Ashtonantony28/nanoxl-accelerator/bench/results/roofline.csv

table | fix | board | model | wbits | N | lanes | mhz | ddr_gbps | kv | batch | fits | prefill_T | prefill_chunk | prefill_ms | prefill_array_util | prefill_gops | decode_tok_s | weight_bound_tok_s | decode_step_us | decode_ddr_util | decode_ddr_MB_per_step | decode_ops_per_byte | decode_gops | why
boards |  | kv260 | tiny | 8 | 32 | 64 | 250.0 | 8.0 | onchip | 1 | True | 128 | 128 | 0.9686 | 0.4779 | 244.6893 | 5317.0749 | 10066.0332 | 188.0733 | 0.585 | 0.8798 | 1.9572 | 9.1557
boards |  | kv260 | tiny | 8 | 32 | 64 | 250.0 | 8.0 | onchip | 4 | True |  |  |  |  |  | 15911.5741 | 40264.1327 | 251.3893 | 0.4415 | 0.881 | 7.8185 | 27.3988
boards |  | kv260 | tiny | 8 | 32 | 64 | 250.0 | 8.0 | onchip | 8 | True |  |  |  |  |  | 23729.9531 | 80528.2654 | 337.1267 | 0.3334 | 0.8825 | 15.6097 | 40.8616
boards |  | kv260 | tiny | 8 | 32 | 64 | 250.0 | 8.0 | ddr | 1 | True | 128 | 128 | 1.2665 | 0.3655 | 187.1444 | 5091.5806 | 10066.0332 | 196.4027 | 0.6023 | 0.947 | 1.8182 | 8.7674
boards |  | kv260 | tiny | 8 | 32 | 64 | 250.0 | 8.0 | ddr | 4 | True |  |  |  |  |  | 14379.8682 | 40264.1327 | 278.1667 | 0.5124 | 1.1499 | 5.9898 | 24.7613
boards |  | kv260 | tiny | 8 | 32 | 64 | 250.0 | 8.0 | ddr | 8 | True |  |  |  |  |  | 20649.5665 | 80528.2654 | 387.4173 | 0.4485 | 1.4204 | 9.6981 | 35.5573
boards |  | kv260 | tiny | 4 | 32 | 64 | 250.0 | 8.0 | onchip | 1 | True | 128 | 128 | 0.9992 | 0.4633 | 237.2093 | 5818.1028 | 19923.4938 | 171.8773 | 0.363 | 0.4989 | 3.4517 | 10.0184
boards |  | kv260 | tiny | 4 | 32 | 64 | 250.0 | 8.0 | onchip | 4 | True |  |  |  |  |  | 16628.8822 | 79693.9751 | 240.5453 | 0.262 | 0.5 | 13.7749 | 28.634
boards |  | kv260 | tiny | 4 | 32 | 64 | 250.0 | 8.0 | onchip | 8 | True |  |  |  |  |  | 23914.6724 | 159387.9503 | 334.5227 | 0.191 | 0.5016 | 27.4649 | 41.1797
boards |  | kv260 | tiny | 4 | 32 | 64 | 250.0 | 8.0 | ddr | 1 | True | 128 | 128 | 1.3071 | 0.3541 | 181.3214 | 5391.1843 | 19923.4938 | 185.488 | 0.3808 | 0.5661 | 3.0417 | 9.2833
boards |  | kv260 | tiny | 4 | 32 | 64 | 250.0 | 8.0 | ddr | 4 | True |  |  |  |  |  | 14745.1304 | 79693.9751 | 271.276 | 0.3488 | 0.769 | 8.9568 | 25.3902
boards |  | kv260 | tiny | 4 | 32 | 64 | 250.0 | 8.0 | ddr | 8 | True |  |  |  |  |  | 20740.7203 | 159387.9503 | 385.7147 | 0.3255 | 1.0395 | 13.252 | 35.7143
boards |  | kv260 | shakespeare | 8 | 32 | 64 | 250.0 | 8.0 | onchip | 1 | True | 256 | 128 | 14.007 | 0.8229 | 421.3302 | 619.0903 | 751.7531 | 1615.2733 | 0.8526 | 11.0091 | 2.041 | 13.9106
boards |  | kv260 | shakespeare | 8 | 32 | 64 | 250.0 | 8.0 | onchip | 4 | False |  |  |  |  |  |  |  |  |  |  |  |  | on-chip KV: 4 x 1179648 B > KVBUF 1572864
boards |  | kv260 | shakespeare | 8 | 32 | 64 | 250.0 | 8.0 | onchip | 8 | False |  |  |  |  |  |  |  |  |  |  |  |  | on-chip KV: 8 x 1179648 B > KVBUF 1572864
boards |  | kv260 | shakespeare | 8 | 32 | 64 | 250.0 | 8.0 | ddr | 1 | True | 256 | 128 | 15.0918 | 0.7638 | 391.045 | 607.4537 | 751.7531 | 1646.216 | 0.8811 | 11.6066 | 1.9359 | 13.6491
boards |  | kv260 | shakespeare | 8 | 32 | 64 | 250.0 | 8.0 | ddr | 4 | True |  |  |  |  |  | 2000.3481 | 3007.0124 | 1999.652 | 0.8344 | 13.4018 | 6.7064 | 44.9466
boards |  | kv260 | shakespeare | 8 | 32 | 64 | 250.0 | 8.0 | ddr | 8 | True |  |  |  |  |  | 3246.6145 | 6014.0247 | 2464.1053 | 0.791 | 15.7955 | 11.3802 | 72.9494
boards |  | kv260 | shakespeare | 4 | 32 | 64 | 250.0 | 8.0 | onchip | 1 | True | 256 | 128 | 14.306 | 0.8057 | 412.5259 | 650.8722 | 1499.988 | 1536.4 | 0.4777 | 5.8666 | 3.83 | 14.6247
boards |  | kv260 | shakespeare | 4 | 32 | 64 | 250.0 | 8.0 | onchip | 4 | False |  |  |  |  |  |  |  |  |  |  |  |  | on-chip KV: 4 x 1179648 B > KVBUF 1572864
boards |  | kv260 | shakespeare | 4 | 32 | 64 | 250.0 | 8.0 | onchip | 8 | False |  |  |  |  |  |  |  |  |  |  |  |  | on-chip KV: 8 x 1179648 B > KVBUF 1572864
boards |  | kv260 | shakespeare | 4 | 32 | 64 | 250.0 | 8.0 | ddr | 1 | True | 256 | 128 | 15.599 | 0.7389 | 378.331 | 644.2436 | 1499.988 | 1552.208 | 0.5198 | 6.4641 | 3.476 | 14.4758
boards |  | kv260 | shakespeare | 4 | 32 | 64 | 250.0 | 8.0 | ddr | 4 | True |  |  |  |  |  | 2090.3928 | 5999.952 | 1913.516 | 0.5321 | 8.2593 | 10.8819 | 46.9698
boards |  | kv260 | shakespeare | 4 | 32 | 64 | 250.0 | 8.0 | ddr | 8 | True |  |  |  |  |  | 3339.1267 | 11999.904 | 2395.836 | 0.5368 | 10.6529 | 16.8738 | 75.0281
boards |  | pynq-z2 | tiny | 8 | 16 | 16 | 150.0 | 1.5 | onchip | 1 | False |  |  |  |  |  |  |  |  |  |  |  |  | on-chip KV: 1 x 131072 B > KVBUF 98304
boards |  | pynq-z2 | tiny | 8 | 16 | 16 | 150.0 | 1.5 | onchip | 4 | False |  |  |  |  |  |  |  |  |  |  |  |  | on-chip KV: 4 x 131072 B > KVBUF 98304
boards |  | pynq-z2 | tiny | 8 | 16 | 16 | 150.0 | 1.5 | onchip | 8 | False |  |  |  |  |  |  |  |  |  |  |  |  | on-chip KV: 8 x 131072 B > KVBUF 98304
boards |  | pynq-z2 | tiny | 8 | 16 | 16 | 150.0 | 1.5 | ddr | 1 | True | 128 | 128 | 4.7282 | 0.6527 | 50.1275 | 1328.9704 | 1887.3812 | 752.4622 | 0.8385 | 0.947 | 1.8182 | 2.2884
boards |  | pynq-z2 | tiny | 8 | 16 | 16 | 150.0 | 1.5 | ddr | 4 | True |  |  |  |  |  | 4252.1125 | 7549.5249 | 940.7089 | 0.8092 | 1.1499 | 5.9898 | 7.3219
boards |  | pynq-z2 | tiny | 8 | 16 | 16 | 150.0 | 1.5 | ddr | 8 | True |  |  |  |  |  | 6661.8553 | 15099.0498 | 1200.8667 | 0.7728 | 1.4204 | 9.6981 | 11.4713
boards |  | pynq-z2 | tiny | 4 | 16 | 16 | 150.0 | 1.5 | onchip | 1 | False |  |  |  |  |  |  |  |  |  |  |  |  | on-chip KV: 1 x 131072 B > KVBUF 98304
boards |  | pynq-z2 | tiny | 4 | 16 | 16 | 150.0 | 1.5 | onchip | 4 | False |  |  |  |  |  |  |  |  |  |  |  |  | on-chip KV: 4 x 131072 B > KVBUF 98304
boards |  | pynq-z2 | tiny | 4 | 16 | 16 | 150.0 | 1.5 | onchip | 8 | False |  |  |  |  |  |  |  |  |  |  |  |  | on-chip KV: 8 x 131072 B > KVBUF 98304
boards |  | pynq-z2 | tiny | 4 | 16 | 16 | 150.0 | 1.5 | ddr | 1 | True | 128 | 128 | 4.9002 | 0.6298 | 48.3677 | 1768.3396 | 3735.6551 | 565.5022 | 0.6659 | 0.5661 | 3.0417 | 3.045
boards |  | pynq-z2 | tiny | 4 | 16 | 16 | 150.0 | 1.5 | ddr | 4 | True |  |  |  |  |  | 5191.1197 | 14942.6203 | 770.5467 | 0.6527 | 0.769 | 8.9568 | 8.9388
boards |  | pynq-z2 | tiny | 4 | 16 | 16 | 150.0 | 1.5 | ddr | 8 | True |  |  |  |  |  | 7773.1786 | 29885.2407 | 1029.18 | 0.644 | 1.0395 | 13.252 | 13.385
boards |  | pynq-z2 | shakespeare | 8 | 16 | 16 | 150.0 | 1.5 | onchip | 1 | False |  |  |  |  |  |  |  |  |  |  |  |  | on-chip KV: 1 x 1179648 B > KVBUF 98304
boards |  | pynq-z2 | shakespeare | 8 | 16 | 16 | 150.0 | 1.5 | onchip | 4 | False |  |  |  |  |  |  |  |  |  |  |  |  | on-chip KV: 4 x 1179648 B > KVBUF 98304
boards |  | pynq-z2 | shakespeare | 8 | 16 | 16 | 150.0 | 1.5 | onchip | 8 | False |  |  |  |  |  |  |  |  |  |  |  |  | on-chip KV: 8 x 1179648 B > KVBUF 98304
boards |  | pynq-z2 | shakespeare | 8 | 16 | 16 | 150.0 | 1.5 | ddr | 1 | True | 256 | 32 | 84.9374 | 0.8873 | 68.1483 | 127.5466 | 140.9537 | 7840.2733 | 0.9868 | 11.6066 | 1.9359 | 2.8659
boards |  | pynq-z2 | shakespeare | 8 | 16 | 16 | 150.0 | 1.5 | ddr | 4 | True |  |  |  |  |  | 436.6636 | 563.8148 | 9160.3689 | 0.9741 | 13.4018 | 6.7064 | 9.8116
boards |  | pynq-z2 | shakespeare | 8 | 16 | 16 | 150.0 | 1.5 | ddr | 8 | True |  |  |  |  |  | 730.1602 | 1127.6296 | 10956.5 | 0.9568 | 15.7955 | 11.3802 | 16.4062
boards |  | pynq-z2 | shakespeare | 4 | 16 | 16 | 150.0 | 1.5 | onchip | 1 | False |  |  |  |  |  |  |  |  |  |  |  |  | on-chip KV: 1 x 1179648 B > KVBUF 98304
boards |  | pynq-z2 | shakespeare | 4 | 16 | 16 | 150.0 | 1.5 | onchip | 4 | False |  |  |  |  |  |  |  |  |  |  |  |  | on-chip KV: 4 x 1179648 B > KVBUF 98304
boards |  | pynq-z2 | shakespeare | 4 | 16 | 16 | 150.0 | 1.5 | onchip | 8 | False |  |  |  |  |  |  |  |  |  |  |  |  | on-chip KV: 8 x 1179648 B > KVBUF 98304
boards |  | pynq-z2 | shakespeare | 4 | 16 | 16 | 150.0 | 1.5 | ddr | 1 | True | 256 | 32 | 83.9819 | 0.8974 | 68.9236 | 185.677 | 281.2478 | 5385.6978 | 0.7994 | 6.4641 | 3.476 | 4.172
boards |  | pynq-z2 | shakespeare | 4 | 16 | 16 | 150.0 | 1.5 | ddr | 4 | True |  |  |  |  |  | 594.0859 | 1124.991 | 6733.0333 | 0.81 | 8.2593 | 10.8819 | 13.3487
boards |  | pynq-z2 | shakespeare | 4 | 16 | 16 | 150.0 | 1.5 | ddr | 8 | True |  |  |  |  |  | 937.5286 | 2249.982 | 8533.0733 | 0.8125 | 10.6529 | 16.8738 | 21.0657
sweep |  | kv260 | shakespeare | 8 | 8 | 64 | 250.0 | 1.5 | onchip | 1 | True | 256 | 128 | 187.0306 | 0.9861 | 31.5541 | 127.6972 | 140.9537 | 7831.028 | 0.9377 | 11.0091 | 2.041 | 2.8693
sweep |  | kv260 | shakespeare | 4 | 8 | 64 | 250.0 | 1.5 | onchip | 1 | True | 256 | 128 | 186.9817 | 0.9863 | 31.5623 | 152.6205 | 281.2478 | 6552.2 | 0.5974 | 5.8666 | 3.83 | 3.4293
sweep |  | kv260 | shakespeare | 8 | 8 | 64 | 250.0 | 4 | onchip | 1 | True | 256 | 128 | 186.881 | 0.9869 | 31.5794 | 174.9424 | 375.8765 | 5716.168 | 0.4821 | 11.0091 | 2.041 | 3.9308
sweep |  | kv260 | shakespeare | 4 | 8 | 64 | 250.0 | 4 | onchip | 1 | True | 256 | 128 | 186.8309 | 0.9871 | 31.5878 | 156.6701 | 749.994 | 6382.84 | 0.23 | 5.8666 | 3.83 | 3.5203
sweep |  | kv260 | shakespeare | 8 | 8 | 64 | 250.0 | 8 | onchip | 1 | True | 256 | 128 | 186.8483 | 0.987 | 31.5849 | 175.8218 | 751.7531 | 5687.576 | 0.2423 | 11.0091 | 2.041 | 3.9506
sweep |  | kv260 | shakespeare | 4 | 8 | 64 | 250.0 | 8 | onchip | 1 | True | 256 | 128 | 186.7981 | 0.9873 | 31.5934 | 157.4167 | 1499.988 | 6352.568 | 0.1156 | 5.8666 | 3.83 | 3.5371
sweep |  | kv260 | shakespeare | 8 | 8 | 64 | 250.0 | 12 | onchip | 1 | True | 256 | 128 | 186.8483 | 0.987 | 31.5849 | 175.8218 | 1127.6296 | 5687.576 | 0.1615 | 11.0091 | 2.041 | 3.9506
sweep |  | kv260 | shakespeare | 4 | 8 | 64 | 250.0 | 12 | onchip | 1 | True | 256 | 128 | 186.7981 | 0.9873 | 31.5934 | 157.4167 | 2249.982 | 6352.568 | 0.0771 | 5.8666 | 3.83 | 3.5371
sweep |  | kv260 | shakespeare | 8 | 16 | 64 | 250.0 | 1.5 | onchip | 1 | True | 256 | 128 | 48.7049 | 0.9466 | 121.1703 | 132.141 | 140.9537 | 7567.672 | 0.97 | 11.0091 | 2.041 | 2.9691
sweep |  | kv260 | shakespeare | 4 | 16 | 64 | 250.0 | 1.5 | onchip | 1 | True | 256 | 128 | 48.656 | 0.9476 | 121.2919 | 233.3805 | 281.2478 | 4284.848 | 0.9132 | 5.8666 | 3.83 | 5.2439
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
wload |  | kv260 | shakespeare | 8 | 32 | 64 | 250.0 | 12 | onchip | 1 | True |  |  |  |  |  | 664.0794 | 1127.6296 | 1505.844 | 0.6094 | 11.0091 | 2.041 | 14.9215
