Ashtonantony28/nanoxl-accelerator/bench/results/breakdown.md

Critical-path share and engine occupancy per op class (`python3 bench/roofline.py`; measured-RTL cycle model).

**kv260 shakespeare W8 decode, as built** (404k cycles per token)

| op class | critical path | engine busy |
|---|---|---|
| dma weights | 63.5 % | 165.2 % |
| dma params | 2.7 % | 5.7 % |
| gemm linear | 28.1 % | 82.4 % |
| gemm attn | 4.7 % | 5.0 % |
| requant | 0.1 % | 4.3 % |
| ln | 0.2 % | 0.7 % |

**kv260 shakespeare W8 prefill, as built** (3502k cycles, T=256)

| op class | critical path | engine busy |
|---|---|---|
| dma weights | 0.0 % | 38.1 % |
| dma params | 0.0 % | 1.3 % |
| dma act/kv | 0.5 % | 0.5 % |
| gemm linear | 76.3 % | 76.1 % |
| gemm attn | 6.5 % | 6.3 % |
| requant | 1.0 % | 14.4 % |
| ln | 4.0 % | 4.0 % |
| softmax | 8.4 % | 8.4 % |
| gelu | 1.1 % | 1.1 % |
| vec add | 1.1 % | 1.1 % |
| kv append | 1.1 % | 1.1 % |

**kv260 shakespeare W8 decode, all fixes** (376k cycles per token)

| op class | critical path | engine busy |
|---|---|---|
| dma weights | 91.9 % | 177.3 % |
| dma params | 3.2 % | 6.2 % |
| gemm linear | 1.5 % | 44.2 % |
| gemm attn | 2.8 % | 2.7 % |
| requant | 0.1 % | 4.6 % |
| softmax | 0.4 % | 0.5 % |

**kv260 shakespeare W8 prefill, all fixes** (3406k cycles, T=256)

| op class | critical path | engine busy |
|---|---|---|
| dma weights | 0.0 % | 39.2 % |
| dma params | 0.0 % | 1.4 % |
| dma act/kv | 0.5 % | 0.5 % |
| gemm linear | 78.5 % | 78.2 % |
| gemm attn | 6.7 % | 6.5 % |
| requant | 1.1 % | 14.8 % |
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
|---|---|---|
| dma weights | 86.1 % | 164.5 % |
| dma params | 1.5 % | 9.5 % |
| dma act/kv | 9.0 % | 17.5 % |
| gemm linear | 3.2 % | 56.2 % |
| gemm attn | 0.1 % | 2.9 % |
| requant | 0.0 % | 2.7 % |

**pynq-z2 shakespeare W4 prefill, all fixes** (12362k cycles, T=256)

| op class | critical path | engine busy |
|---|---|---|
| dma weights | 0.8 % | 47.1 % |
| dma params | 0.3 % | 3.1 % |
| dma act/kv | 2.9 % | 9.6 % |
| gemm linear | 84.2 % | 86.1 % |
| gemm attn | 5.3 % | 5.5 % |
| requant | 0.2 % | 4.9 % |
| ln | 1.7 % | 1.8 % |
| softmax | 2.7 % | 2.8 % |
| gelu | 1.2 % | 1.2 % |
| vec add | 0.6 % | 0.6 % |
