Ashtonantony28/nanoxl-accelerator/bench/results/roofline.png

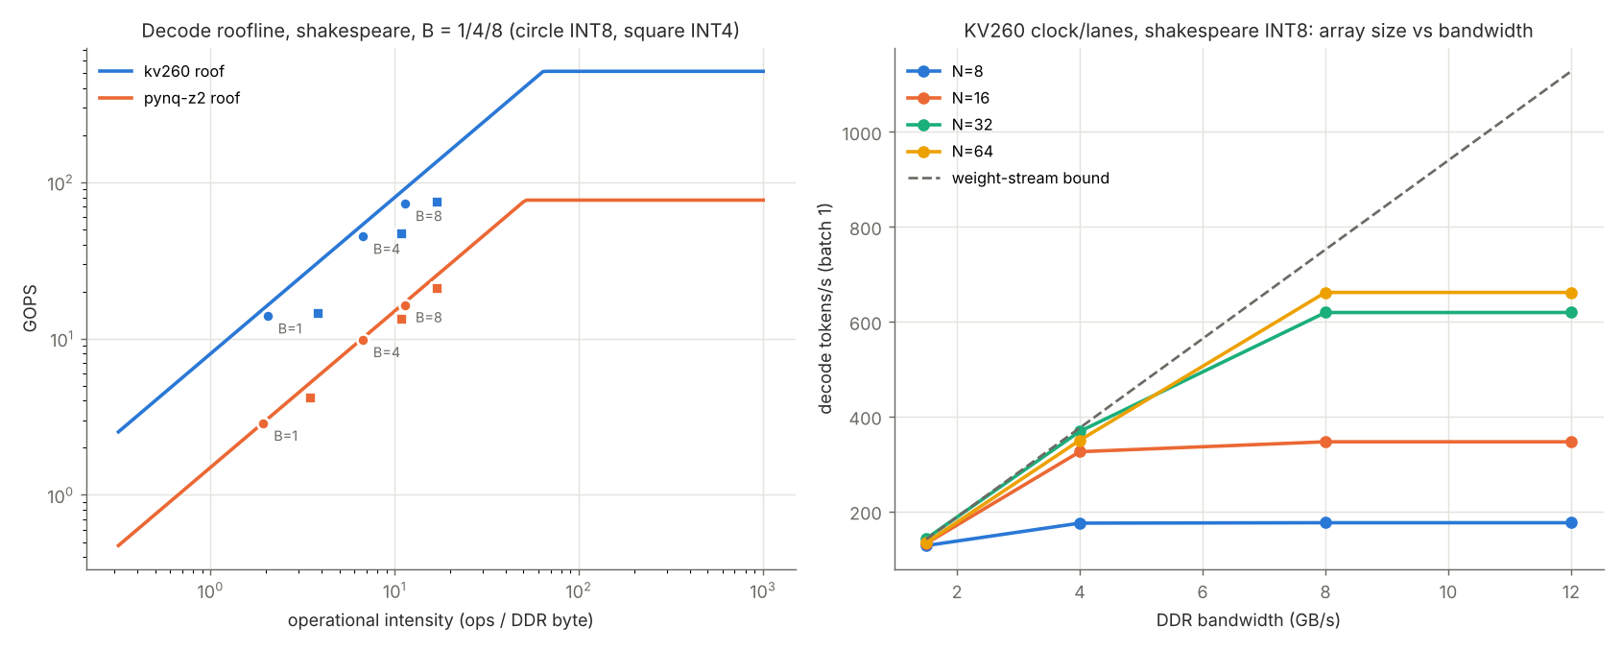
bench/results/roofline.png
