Ashtonantony28/nanoxl-accelerator/tests/rtl/vec_unit_cocotb.py

"""cocotb bench for rtl/vec_unit.sv: random command sequences over rows of random length,
all streams with random valid gaps / backpressure, and a behavioural SFU on the hook port."""
from __future__ import annotations
import random

import cocotb
import numpy as np
from cocotb.triggers import FallingEdge, ReadOnly

from nanoxl import numerics as nx
from nanoxl import vec_ref as vr
from vec_common_cocotb import Sink, Source, env_int, pack, run_bench, start, u, unpack

L = env_int("L", 4)
HAS_SFU = env_int("HAS_SFU", 1)
N_CMDS = env_int("N_CMDS", 150)
ACC_W = vr.REDUCE_ACC_W
M32 = 0xFFFFFFFF

INPUTS = ["cmd_valid", "cmd_op", "cmd_len", "cmd_fmt", "cmd_shamt", "cmd_lo", "cmd_hi",
          "cmd_b_imm", "cmd_imm_b", "cmd_p_imm", "cmd_mult", "a_valid", "a_data", "b_valid",
          "b_data", "p_valid", "p_mult", "p_shift", "d_ready", "r_ready", "sfu_in_ready",
          "sfu_out_valid", "sfu_out_data", "sfu_out_keep", "sfu_out_last", "stat_clr"]


def wrap32(v):
    return ((int(v) + (1 << 31)) & M32) - (1 << 31)


def sfu_model(x, op, imm, shamt, fmt):
    """What the behavioural SFU stub computes (lets the bench check every hook field)."""
    return wrap32(3 * x + 1000 * op + imm + 7 * shamt + 100000 * fmt)


def unit_of(op):
    if op < 0x10:
        return "alu"
    if op == vr.VOP_REQUANT:
        return "rq"
    if op == vr.VOP_REDUCE:
        return "red"
    if op >= 0x18 and HAS_SFU:
        return "sfu"
    return "alu"            # reserved / SFU without HAS_SFU -> PASS, illegal_op


def is_illegal(op):
    return op >= 0x10 and unit_of(op) == "alu"


def rand_val(rng):
    r = rng.random()
    if r < 0.3:
        return rng.randrange(nx.INT32_MIN, nx.INT32_MAX + 1)
    if r < 0.7:
        return rng.randrange(-32768, 32768)
    return rng.randrange(-300, 300)


def rand_cmd(rng):
    ops = list(range(10)) + [0x0B, vr.VOP_REQUANT, vr.VOP_REQUANT, vr.VOP_REDUCE, vr.VOP_REDUCE,
                             0x13, 0x18, 0x19, 0x1F, 0x1C]
    op = rng.choice(ops)
    r = rng.random()
    n = (0 if r < 0.05 else rng.randrange(1, L + 1) if r < 0.35 else
         rng.randrange(L + 1, 5 * L + 4) if r < 0.95 else 384)
    lo, hi = sorted(rng.randrange(-500, 500) for _ in range(2))
    return {"op": op, "len": n, "fmt": rng.randrange(4), "shamt": rng.randrange(32), "lo": lo,
            "hi": hi, "b_imm": int(rng.random() < 0.3), "imm_b": rand_val(rng),
            "p_imm": int(rng.random() < 0.3), "mult": rng.randrange(1 << 30, 1 << 31)}
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
