Ashtonantony28/nanoxl-accelerator/tests/rtl/sfu_elem_cocotb.py

"""cocotb bench for rtl/sfu_elem.sv (EXP2, RECIP, RSQRT, GELU lanes) vs nanoxl.quant.ops.

Tables are loaded at run time through the write port: the bundle's tables, and in one
test random tables (the unit must follow whatever was loaded).
"""
from __future__ import annotations
import random

import cocotb
import numpy as np
from cocotb.triggers import FallingEdge, ReadOnly, RisingEdge

from sfu_common_cocotb import (OP_EXP2, OP_GELU, OP_RECIP, OP_RSQRT, Sink, Source, bundle_luts, table_lines,
                               env_int, pack, ref_elem, run_bench, start, u, unpack, write_port)

L = env_int("L", 4)
NG = env_int("NG", 4)
EL = env_int("EL", L)          # EXP2 / RECIP / RSQRT primitive lanes
R = L // EL                     # cycles per EXP2 / RECIP / RSQRT beat
EXHAUSTIVE = env_int("EXHAUSTIVE", 1)
N_RAND = env_int("N_RAND", 2000)
INPUTS = ["in_valid", "in_op", "in_slot", "in_data", "in_keep", "in_last", "out_ready",
          "lut_we", "lut_waddr", "lut_wdata"]


async def load_tables(dut, exp_lut, recip_lut, rsqrt_lut, gelu):
    w = []
    for bit, t in ((0, exp_lut), (1, recip_lut), (2, rsqrt_lut)):
        w += [(1 << bit, i, ln) for i, ln in enumerate(table_lines(np.asarray(t, np.uint16)))]
    for s, t in enumerate(gelu):
        w += [(8, (s << 4) | i, ln) for i, ln in enumerate(table_lines(np.asarray(t, np.int8)))]
    await write_port(dut, w, "lut_we", "lut_waddr", "lut_wdata")


def recip_inputs(rng, n):
    edges = [1 << 15, (1 << 15) + 1, (1 << 16) - 1, 1 << 16, (1 << 24), (1 << 24) - 1, (1 << 32) - 1]
    for b in range(15, 32):
        edges += [1 << b, (1 << (b + 1)) - 1, (1 << b) | (127 << max(b - 9, 0))]
    rnd = [rng.randrange(1 << rng.randrange(15, 32), 1 << 32) if rng.random() < 0.5 else
           rng.randrange(1 << 15, 1 << 25) for _ in range(n)]
    return [v for v in edges + rnd if v >= 1 << 15]
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
