Ashtonantony28/nanoxl-accelerator/(commit log)

2026-11-06 SG4: 128-bit command ISA, encoder/decoder, golden vectors, docs/isa.md
    Claude-Session: https://claude.ai/code/session_01VH3AycXYtBhtexbRUyaRKj
2026-11-06 rtl: tile controller, scratchpad SRAM/FIFO, skewed weight writes
    array_ctrl sequences preload/compute/accumulate per weight tile with
    double-buffered PE banks, K accumulation in an INT32 scratchpad with a
    read-during-write bypass, ragged K/N masking, INT4 weights, and
    credit-based output flow control. Weight writes now travel diagonally
    with the activation wavefront, so a bank is reloaded right behind its
    last activation and tiles stream at max(M,K) cycles with no bubbles.
    The simulation checker tracks a per-tile generation bit per PE.
    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
2026-11-06 SG4: sizing study, roofline bench, ADR-003; sync regression test; model fixes
    Non-blocking SIGNAL in the cycle model, cross-command weight preload, panel size knob,
    2-row weight port on KV260.
    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
    [roofline.csv]
2026-11-06 SG1: tiny quantization study data; pin exp-poly study variant at 2^0
    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
2026-11-07 SG4b: C5 integer lowering, GEMM_GS/LUT_LOAD opcodes, alignment rule, bundle graph, host runner
    Compiler and funcsim now consume the SG1 bundle: LN, softmax (score requant + full-row
    3-pass), GELU LUT, INT16 residual adds and W4A8 group scales execute the nanoxl.quant.ops
    reference ops; float placeholders are gone. New opcodes GEMM_GS (0x12) and LUT_LOAD (0x1E)
    are additive; existing encodings and golden vectors unchanged. 16-byte base alignment is
    enforced by the encoder (aligned=True), the compiler and funcsim. Saturation events are
    counted per command under golden-model names.
    Claude-Session: https://claude.ai/code/session_01VH3AycXY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
2026-11-07 SG6: control-plane RTL (fifo, semaphores, generated ISA decoder, fetcher, queues, DMA, CSR); DMA tests
    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
2026-11-07 SG5: LayerNorm RTL (C5) with slot parameters, saturation counters, golden LN rows
    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
2026-11-07 SG4b: headline funcsim-vs-golden test, ADR-004, cycle-model costs, regenerated bench
    tests/py/test_funcsim_golden.py compiles the tiny W8A8 and W4A8 bundles and checks every
    step's logits, the KV cache, per-op saturation counts and the 100-token greedy sequences
    against nanoxl.golden and golden_ref.json (single-shot and chunked prefill, on-chip and DDR
    KV, batched decode); a slow shakespeare variant runs when the checkpoint is present.
    Cycle model costs GEMM_GS (scale beat per group), 3-pass C5 LN/softmax and LUT_LOAD.
    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
    [roofline.csv]
2026-11-07 SG6: decoder handles GEMM_GS/LUT_LOAD (regenerated), retire count fix, ctrl tests pass
    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
    [cmd_decode.sv, cmd_proc.sv, cmd_queue.sv, ctrl_cocotb.py, dma_cocotb.py, test_ctrl.py]
2026-11-07 SG5: take tables and parameters in the ISA PBUF layouts (ADR-004)
    Line-wide (16-byte PBUF line) table writes for LUT_LOAD and GELU, LN parameter
    block loaded verbatim (funcsim.ln_block layout), softmax score-record slots with
    the SOFTMAX_ONLINE requant front end (ls, bias, causal limit, score sat counter).
    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
2026-11-07 SG4c: cycle model on measured RTL costs, coalesced DMA emission, semaphore stream-limit check
    Cycle model: command fetch over AXI, 8-deep queues, blocking SIGNAL, non-pipelined
    byte-granular DMA (16 B/beat, 4 outstanding bursts, row bubble), C3 tile max(M,k) and
    2N+4 latency, measured LN/softmax/LUT costs; critical-path attribution per op class;
    what-if timing switches for proposed fixes.
    Compiler: contiguous DMAs are emitted as single-row commands (int8 weight panels were
    384 x 64 B rows, burst-latency bound in the measured DMA).
    funcsim.check_hazards rejects > 255 + 8 outstanding SIGNALs per semaphore.
    Claude-Session: https://claude.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
2026-11-07 SG4c: regenerate bench results on the measured-RTL model; ADR-003 update (breakdown, top 3 bottlenecks)
    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
    [roofline.csv]
2026-11-07 SG4c: host driver (nanoxl/driver): NanoXL API, SimBackend CSR emulation over funcsim, PynqBackend, CLI, docs/driver.md
    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
2026-11-07 SG7b: WIP tiny/errors/clear/residency benches
    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
    [vec_seq_cocotb.py, vec_seq_common_cocotb.py]
2026-11-07 SG7b: tiny W8A8 pass, errors, clear/reset mid-command and residency benches
    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
    [test_vec_seq.py, vec_seq_cocotb.py, vec_seq_common_cocotb.py]
2026-11-07 SG7b: layernorm lane-position fix for L >= 32, L=64 bench, docs (vector-unit §9, sfu §10), PLAN
    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
    [layernorm.sv]
2026-11-07 SG7c: nanoxl_top (ctrl_top + engines + banked scratchpads), driver-in-the-loop cocotb bench
    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
2026-11-07 A1-02: one canonical SAT CSR map (vec_seq order, NSAT=5) in RTL, driver, SimBackend, docs
    nanoxl_top wires vec_seq.sat_cnt straight to ctrl_top (NSAT=5 default in ctrl_top/csr_axil);
    csr.SAT_NAMES = requant, alu, ln_out, ln_z, score; SimBackend charges LN z to slot 3, LN out to
    slot 2, softmax score to slot 4. Audit xfail now a passing test; ctrl test reads SAT_0..4.
    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
2026-11-07 SG7c: docs/top.md, slot parameters on nanoxl_top, Icarus prefill smoke
    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
2026-11-07 A1-01/A1-05: cycle model priced on measured vec_seq and array_seq costs
    VEC engine: 16-byte line ports, REQUANT record lines, per-L fixed costs fitted to
    bench/vec_seq_perf.py measurements at L = 4/16/64 (docs/vector-unit.md 9.3); GEMM_GS
    scale beat per tile, ragged W rows, array_seq accept->done latency, LN/LUT_LOAD costs.
    Adds the 64-byte VEC port what-if; regenerates bench/results.
    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
    [roofline.csv]
2026-11-07 A1-10: formal tests fail when NANOXL_REQUIRE_FORMAL=1 and a tool is missing; CI sets it, installs z3/torch, runs tests/audit
    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
    [test_ctrl_formal.py]
2026-11-07 cyclemodel: pin whole tiny programs to the measured nanoxl_top cycles (docs/top.md 6) within 10 %
    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
2026-11-07 PLAN: wave 5 (SG9a FPGA flow, SG10a dual DMA, SG10b wide VEC ports)
    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
2026-11-07 SG10a: two DMA engines on chan[0], LOAD pipelining, SIGNAL carried on done, STORE fence
    cmd_queue gains NCH channels, a fence flag and a pending-SIGNAL buffer; the DMA queue
    dispatches to dma_engine x2 (md_axi / md1_axi, sp_ / sp1_). dma_engine keeps up to NCMD
    commands in flight with separate address and data stages. Tests: pipelined-load timing,
    dual-DMA directed cases, two-channel scoreboard, pipelined AXI read latency model.
    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
2026-11-07 bench/results: regenerate roofline/fixes/breakdown with 4-line VEC ports as built; PLAN SG10b done
    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
    [roofline.csv]
2026-11-07 SG9a: Vivado wrapper, KV260/PYNQ-Z2 build scripts, Yosys estimate flow, first-light tools, tests/fpga
    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
2026-11-07 SG9a: VP=4 (SG10b) in wrapper, board params, build scripts and estimates
    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
2026-11-07 SG10a: compiler channel assignment, two-channel hazard checker, cycle model built defaults, queue formal proof
    - compiler: WBUF panels to the less-loaded DMA channel, K/V loads on channels 2/3; SyncBuilder
    tracks the two DMA channels as separate agents, moves a conflicting LOAD or orders it with a
    DMA->DMA semaphore (sem 6); STORE is a fence
    - funcsim.check_hazards: DMA channels as agents (unordered cross-channel WAW is a race)
    - cyclemodel: two engines, pipelined, carried SIGNALs are the built defaults (PRE_SG10A keeps
    the old engine); measured RTL decode within 0.1 %
    - cmd_queue: inline FIFO, WW parameter, formal job 'queue' (SIGNAL ordering across channels,
    STORE fence, pending-bu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
2026-11-07 SG10a: ADR-005, docs/top.md ports and router, regenerated bench results, PLAN status
    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
    [roofline.csv]
2026-11-07 contracts: C6 DMA channel ordering (ADR-005)
    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
2026-11-07 SG11b: vec_seq record buffer one write source per entry; RAM_STYLE board params replace the XDC RAM patterns; wrapper regenerated
    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
    [vec_seq.sv]
2026-11-07 SG11c: C4 multi-cycle VEC MUL and 35-bit ALU datapath, C6 srdhm stage-3 identity + NDSP option, C7 pipelined reduce tree
    vec_alu: one 17x17 DSP per lane over 4 partial products, serial rounding shift,
    MUL at 7+shamt cycles/beat; other ops unchanged rate/depth. srdhm: trunc(p+nudge,2^31)
    = ((p>>>30)+1)>>>1; NDSP=3 decomposition as an option. vec_reduce: tree cut every
    2 levels (latency 2+ceil(log2 L/2)). Bit-identical; tests extended.
    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
2026-11-07 SG11c: C5 WP486 INT8 2-MAC packing (pe_pair), systolic_array PACK=1 default
    One DSP48E2 per PE pair; column 2p+1 is written with column 2p and its product is
    registered one cycle, so array timing and bank rules are unchanged. Exhaustive
    2^24-case pe_pair test (Verilator; 1/13 subset on Icarus); array core tests at PACK 0/1.
    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
2026-11-11 tests: DMA ch1 PBUF loads at top level (A2-03), vec_reduce at L=32/64 (A2-04)
    test_top_smoke_pbuf_ch1 (Verilator) moves every parameter-block load to DMA
    channel 1, racing a channel-0 PBUF load: kills top_snoop_ch1 and top_ch1_gate.
    test_vec_reduce[32]/[64] cover the three-stage tree: kills vr_nts32.
    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
2026-11-11 CI: per-push Verilator fast job, nightly Verilator slow job (A2-01/A2-02); docs (A2-06)
    ci.yml builds Verilator v5.040 from source once (actions/cache keyed on the
    version); verilator-fast runs make test-verilator-fast (the cocotb fast tier on
    Verilator) on every push/PR; slow runs make test-slow SIM=verilator nightly and
    on workflow_dispatch. The Icarus job stays. AUDIT-2 xfails turned into tests that
    pin the fixes. PLAN status, docs/top.md test table, ADR-006 citations and the
    systolic_array PACK=1 header comment updated.
    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
    [systolic_array.sv, test_top.py]
2026-11-11 SG12: first-bitstream board configuration (ADR-006)
    KV260: N=8, L=4, VP=1, NB=2, KVBUF 512 KiB, 200 MHz (Yosys LUT incl. LUTRAM
    62 % of the XCK26); PYNQ-Z2 smallest useful build (N=8, L=4) is 123 % of the
    XC7Z020 and kept as a reference. estimate.py counts LUTRAM in LUT6 sites;
    resources_*.json regenerated; hwconfig.BOARDS gains the -fpga entries
    (mirrored by a test); roofline sweeps only the planning boards; slow
    Verilator test runs tiny bit-exact at the exact board parameters.
    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
2026-11-11 docs/top.md §6: headline table re-measured on current RTL (A2-06); PLAN SG11c row
    test_top_tiny (Verilator, 4 configs, bit-exact) with TOP_PERF_DIR: W8A8 on-chip
    prefill 76,394, decode 61,923-62,035; DDR KV rows measured for the first time
    since SG10a. The PLAN SG11c row is byte-identical to SG12's d15093d.
    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
2026-11-11 cyclemodel: -fpga board configs use their planning board's timing
    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
